CaptainHabibi/Skripsie_Automated_Aquaponic_Control_Platform/ESP32_Pinout.png

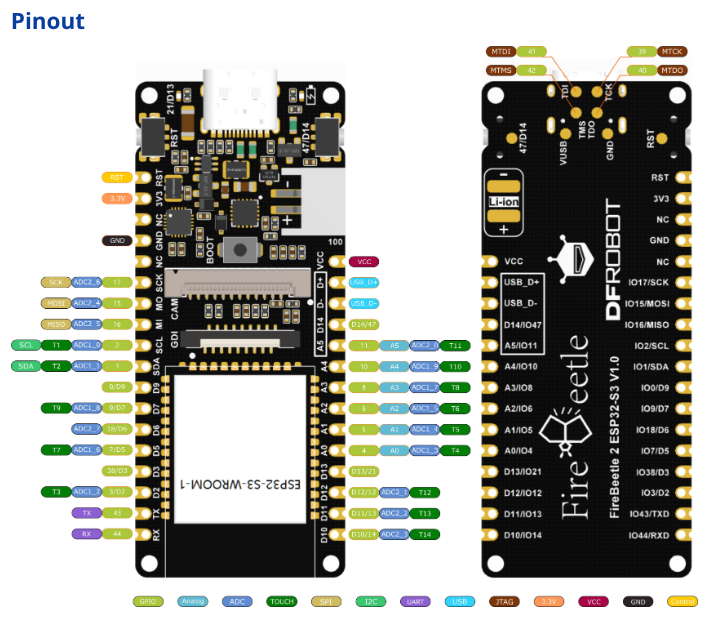
ESP32_Pinout.png
