CaptainHabibi/Skripsie_Automated_Aquaponic_Control_Platform/Screenshot From 2026-08-03 09-43-30.png

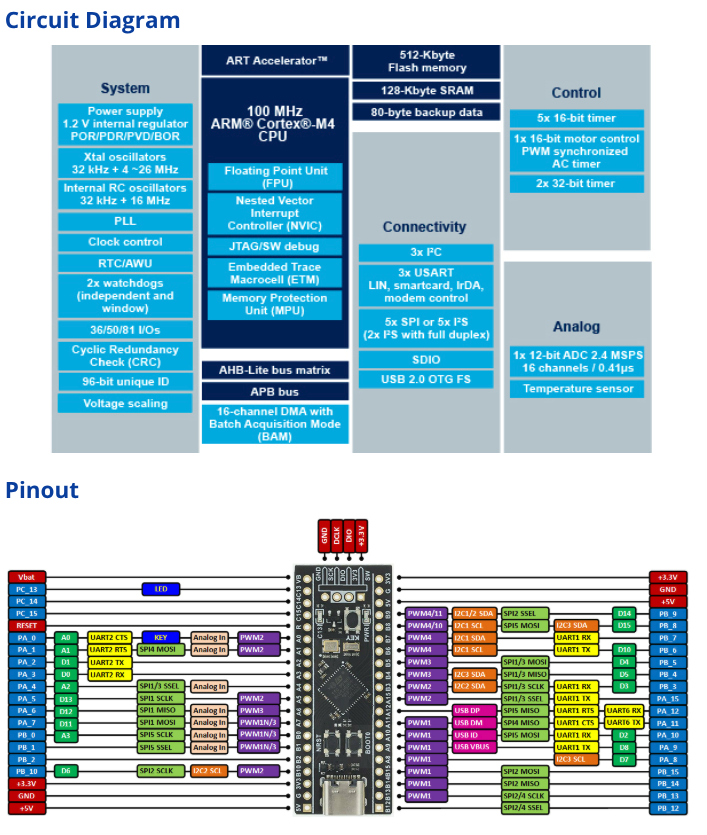
Screenshot From 2026-08-03 09-43-30.png
