CaptainHabibi/Skripsie_Automated_Aquaponic_Control_Platform/Actual_STM.png

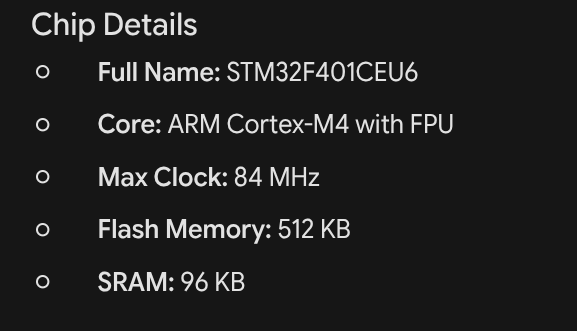
Actual_STM.png
