CaptainHabibi/Skripsie_Automated_Aquaponic_Control_Platform/Esp32_Board.png

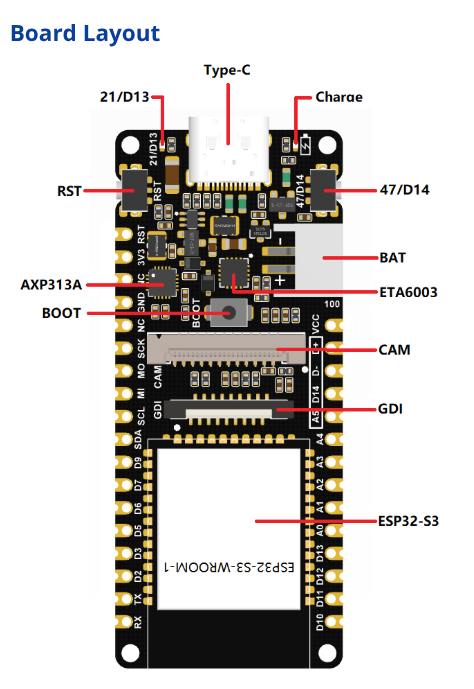
Esp32_Board.png
