CaptainHabibi/Skripsie_Automated_Aquaponic_Control_Platform/ESP32_QuickSpec.png

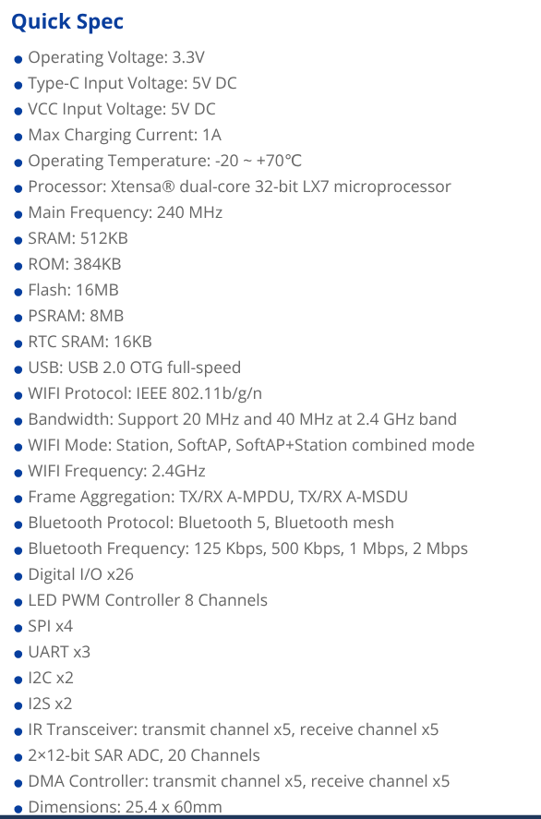
ESP32_QuickSpec.png
