CaptainHabibi/Skripsie_Automated_Aquaponic_Control_Platform/LoRaPinOut_SX1278_LoRa.png

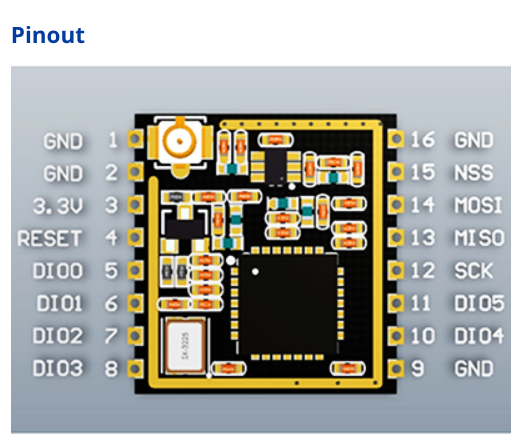
LoRaPinOut_SX1278_LoRa.png
