CaptainHabibi/Skripsie_Automated_Aquaponic_Control_Platform/Servo_Specs.png

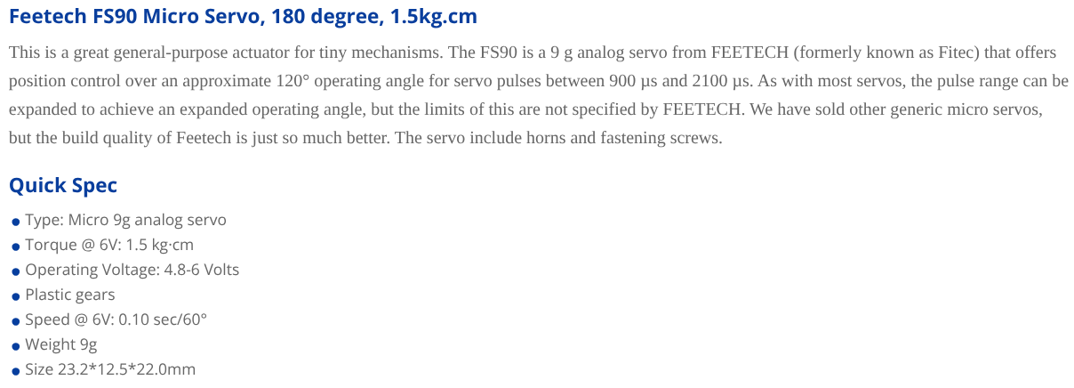
Servo_Specs.png
