CaptainHabibi/Skripsie_Automated_Aquaponic_Control_Platform/SubmersiblePump.png

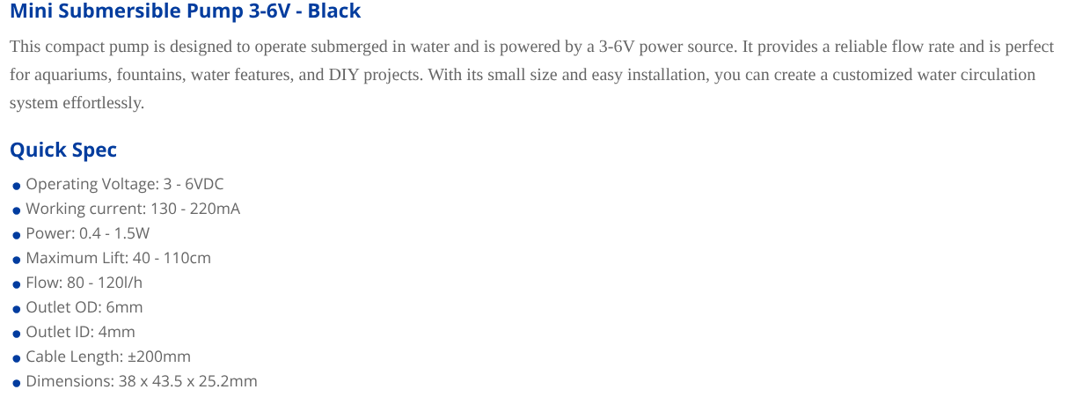
SubmersiblePump.png
