CaptainHabibi/Skripsie_Automated_Aquaponic_Control_Platform/Turbidity.png

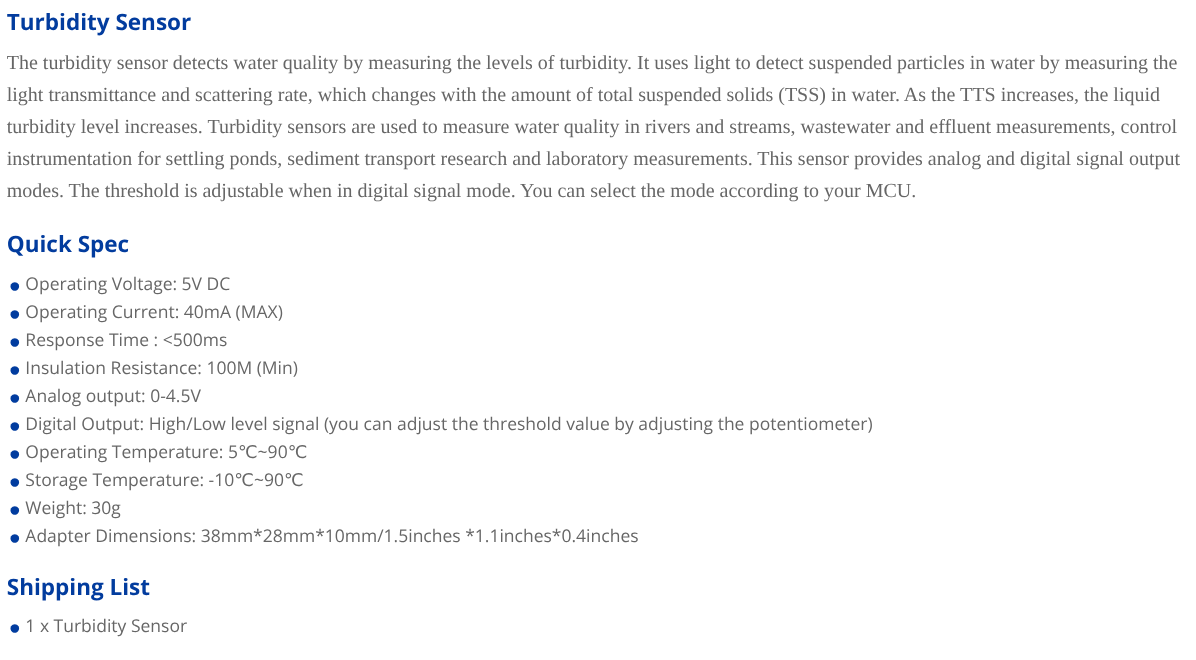
Turbidity.png
