CaptainHabibi/Skripsie_Automated_Aquaponic_Control_Platform/Hardware/Skripsie-PaddleWheel.stl

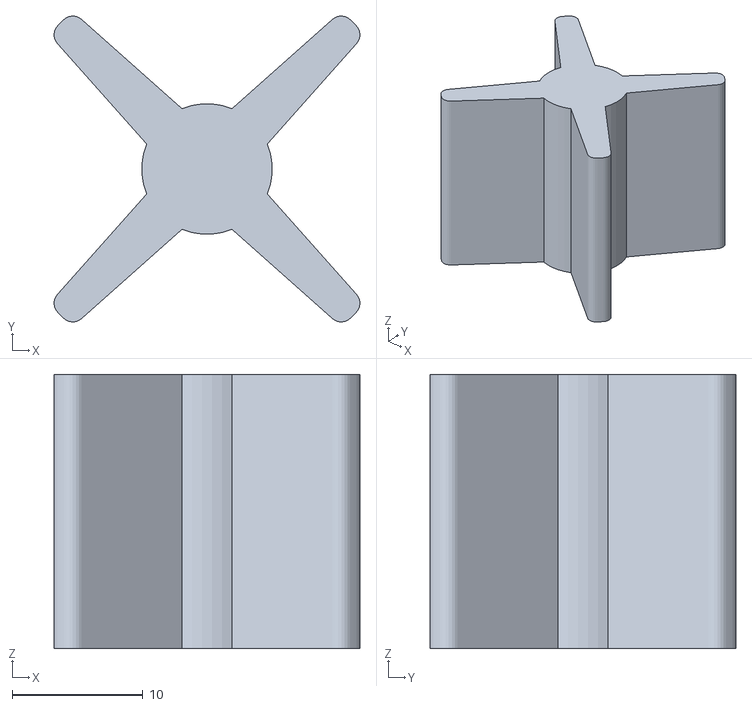
[picture p10: CAD file, 2026-10-30]
Hardware/Skripsie-PaddleWheel.stl
23.4 x 23.4 x 21.0
