CaptainHabibi/Skripsie_Automated_Aquaponic_Control_Platform/Hardware/Skripsie-BackCover.stl

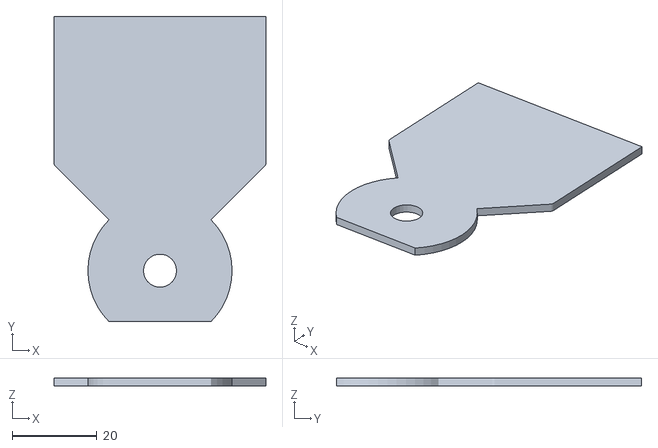
[picture p11: CAD file, 2026-10-30]
Hardware/Skripsie-BackCover.stl
50.0 x 72.0 x 2.00
