CaptainHabibi/Skripsie_Automated_Aquaponic_Control_Platform/Hardware/Receiver_Lid.stl

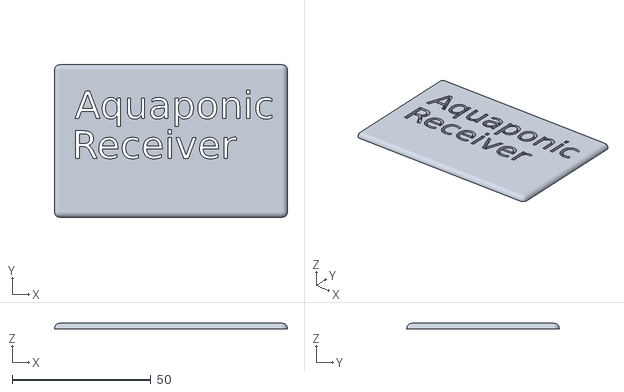
[picture p12: CAD file, 2026-10-30]
Hardware/Receiver_Lid.stl
84.0 x 55.0 x 2.00
