CaptainHabibi/Skripsie_Automated_Aquaponic_Control_Platform/Hardware/UltrasonicMount.stl

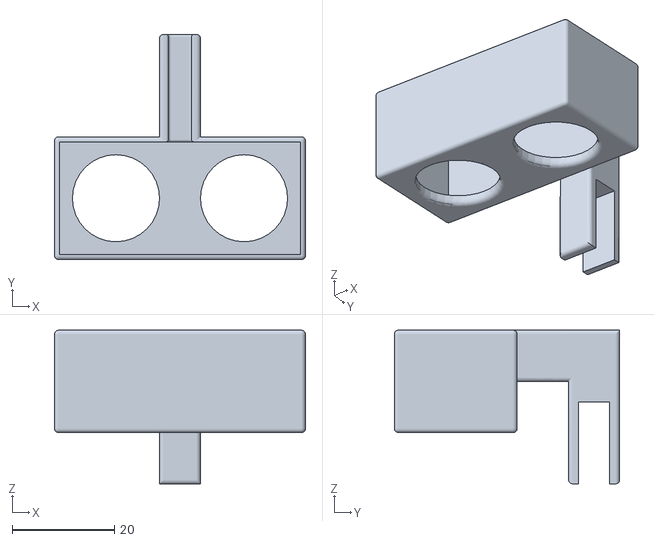
[picture p13: CAD file, 2026-10-30]
Hardware/UltrasonicMount.stl
49.0 x 44.0 x 30.0
