CaptainHabibi/Skripsie_Automated_Aquaponic_Control_Platform/Hardware/Receiver_Box.stl

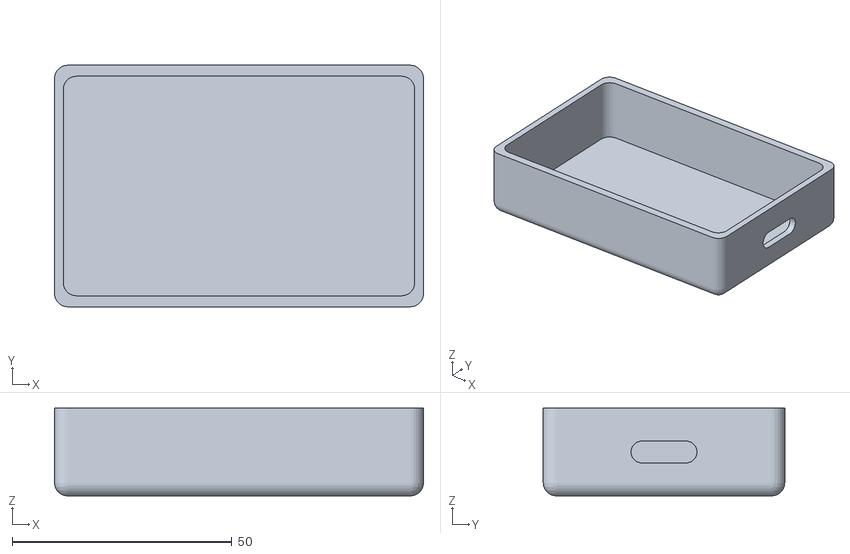
[picture p14: CAD file, 2026-10-30]
Hardware/Receiver_Box.stl
84.0 x 55.0 x 20.0
