CaptainHabibi/Skripsie_Automated_Aquaponic_Control_Platform/Hardware/Skripsie-Housing.stl

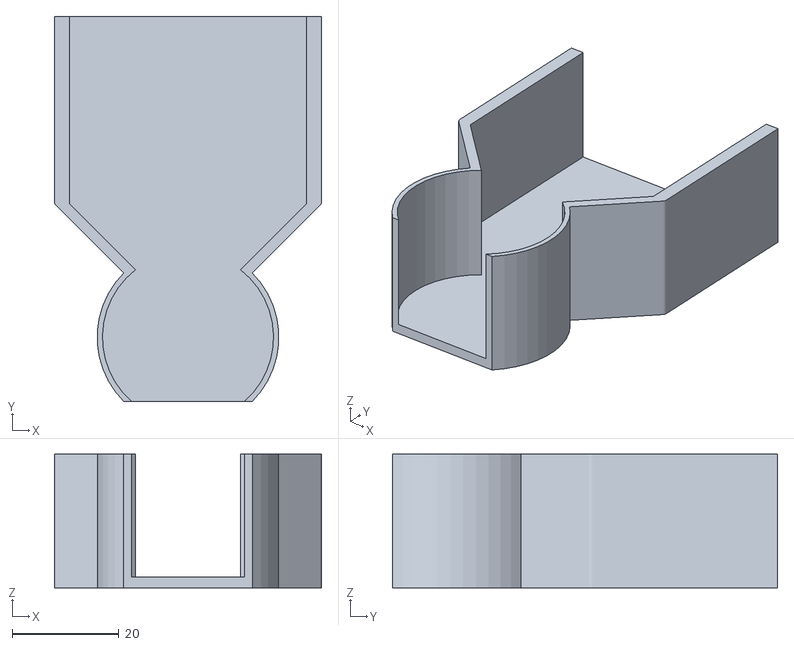
[picture p15: CAD file, 2026-10-30]
Hardware/Skripsie-Housing.stl
50.0 x 72.0 x 25.0
