CaptainHabibi/Skripsie_Automated_Aquaponic_Control_Platform/Hardware/ServoMount.stl

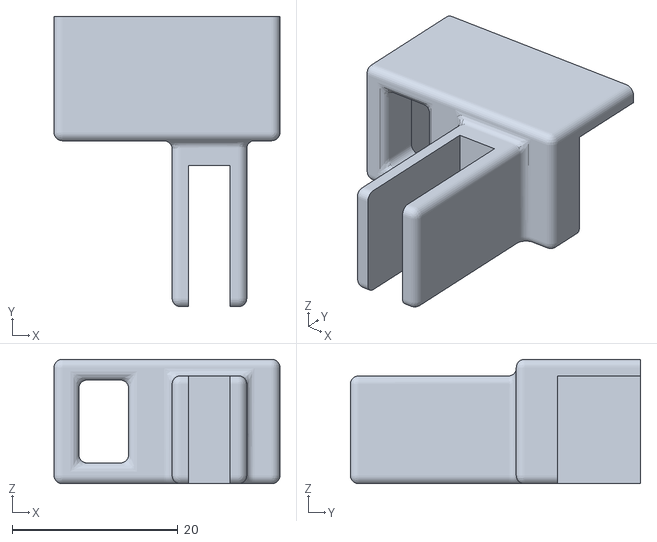
[picture p16: CAD file, 2026-10-30]
Hardware/ServoMount.stl
27.2 x 35.0 x 15.0
