CaptainHabibi/Skripsie_Automated_Aquaponic_Control_Platform/Hardware/Skripsie.pdf

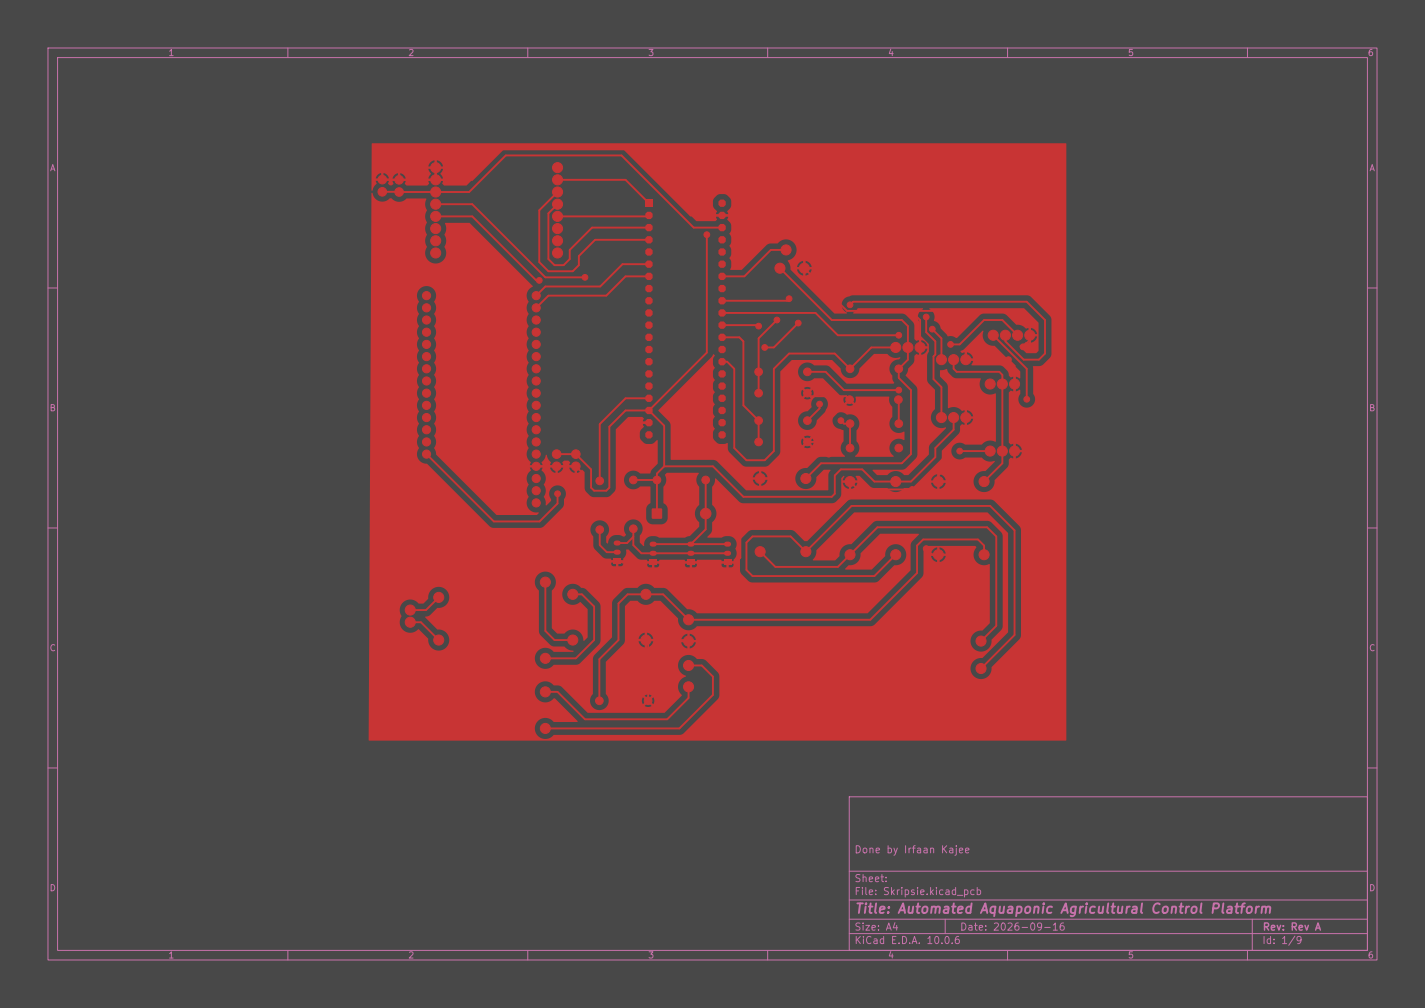
[picture p17: page 1]

Done by Irfaan Kajee

Sheet:
File: Skripsie.kicad_pcb
Title: Automated Aquaponic Agricultural Control Platform

Size: A4 | Rev: Rev A
KiCad E.D.A. 10.0.6 | Id: 1/9

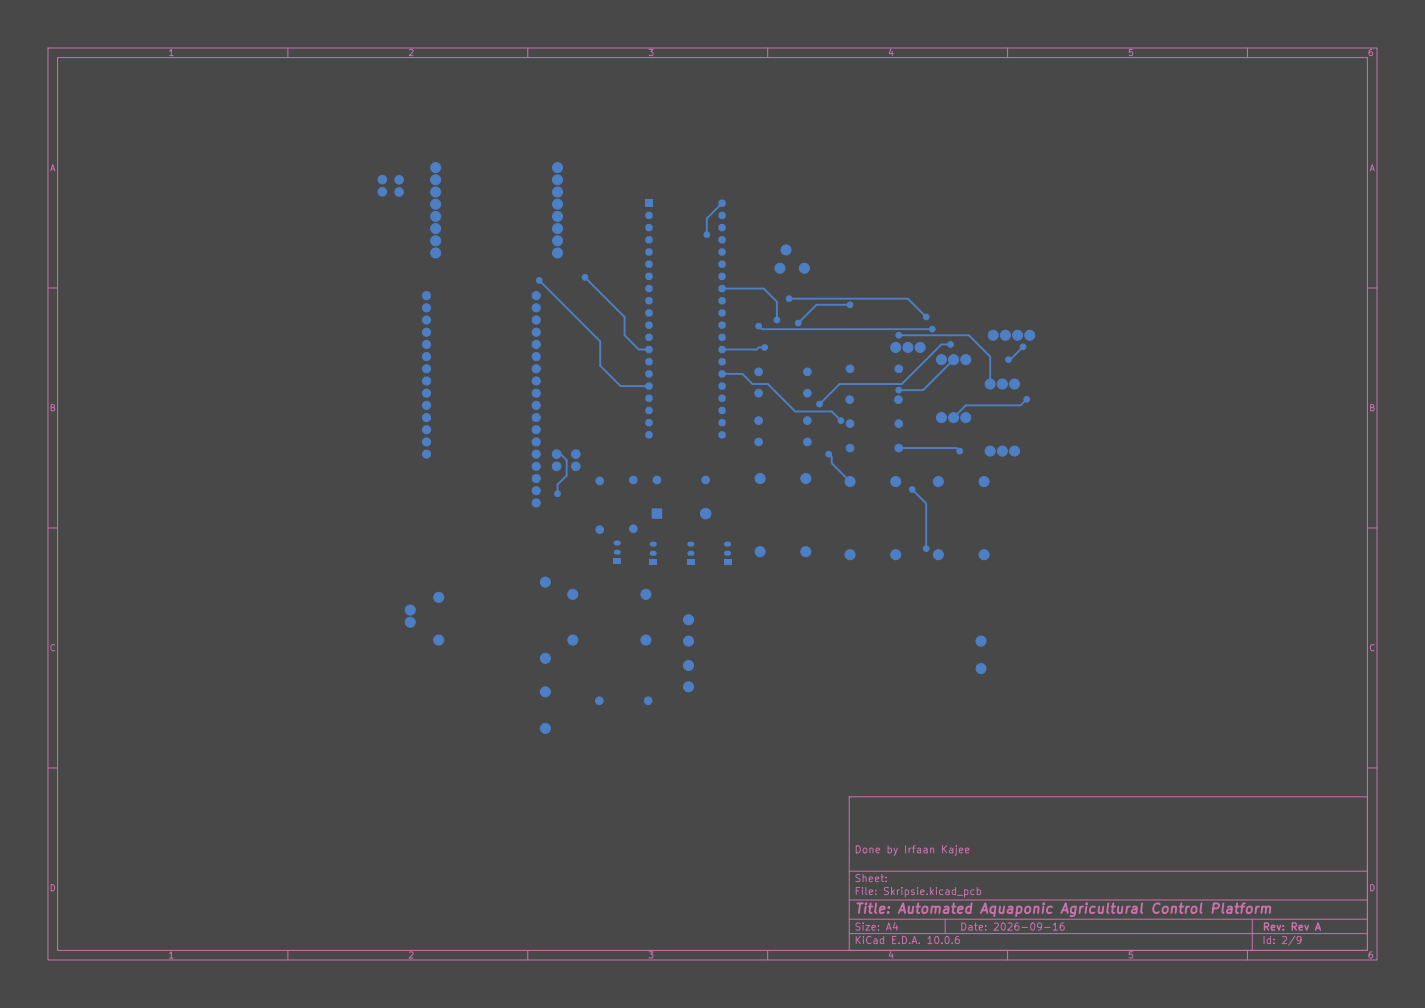
[picture p18: page 2]

Done by Irfaan Kajee

Sheet:
File: Skripsie.kicad_pcb
Title: Automated Aquaponic Agricultural Control Platform

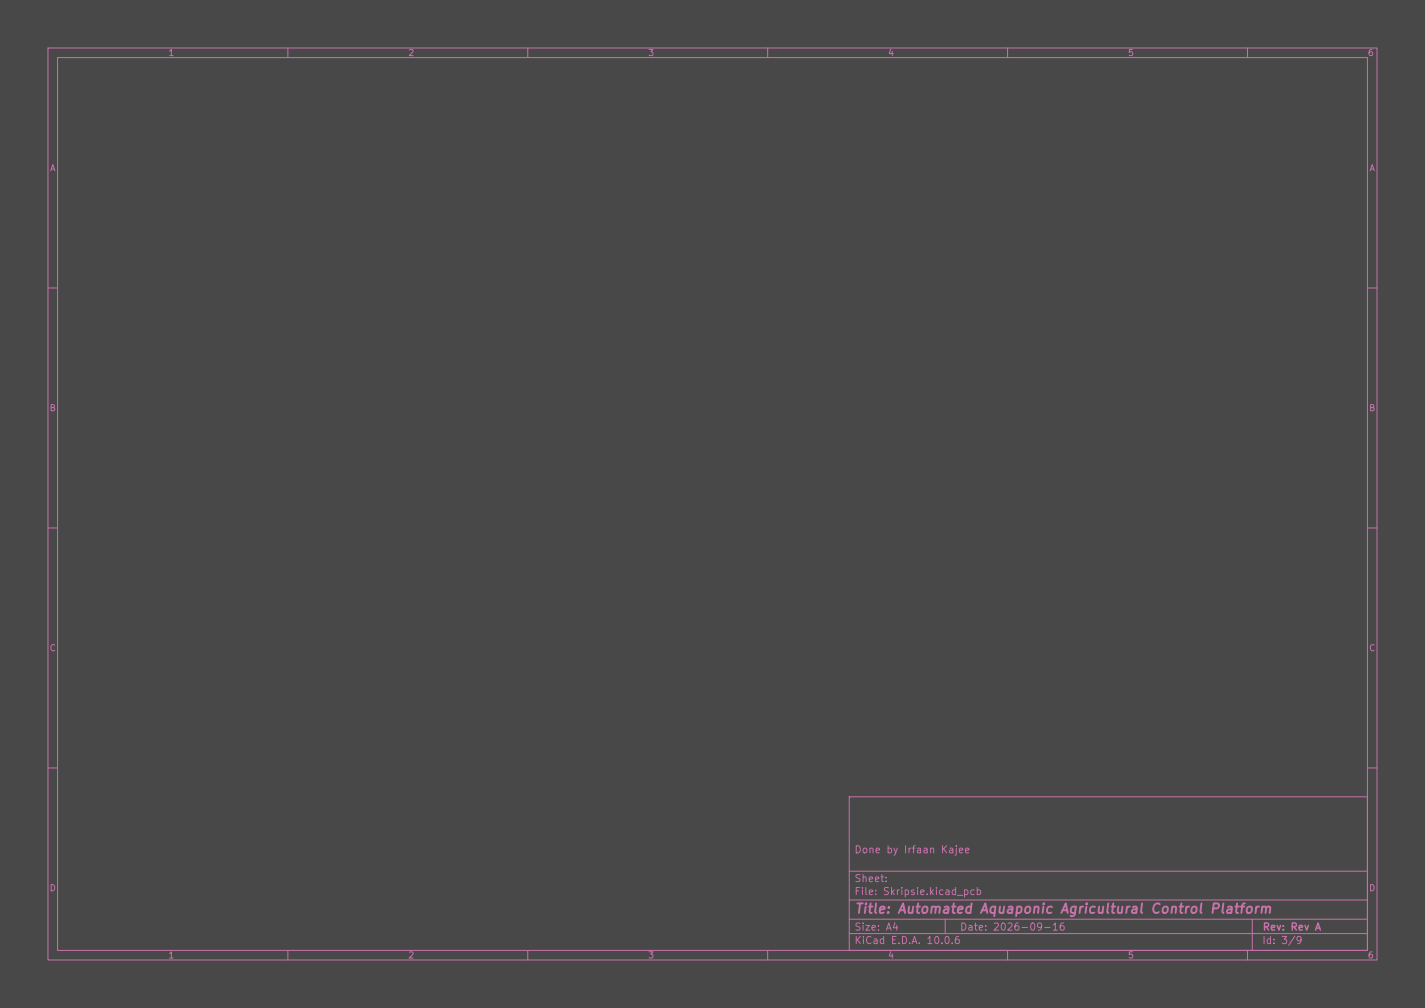
[picture p19: page 3]

Done by Irfaan Kajee

Sheet:
File: Skripsie.kicad_pcb
Title: Automated Aquaponic Agricultural Control Platform

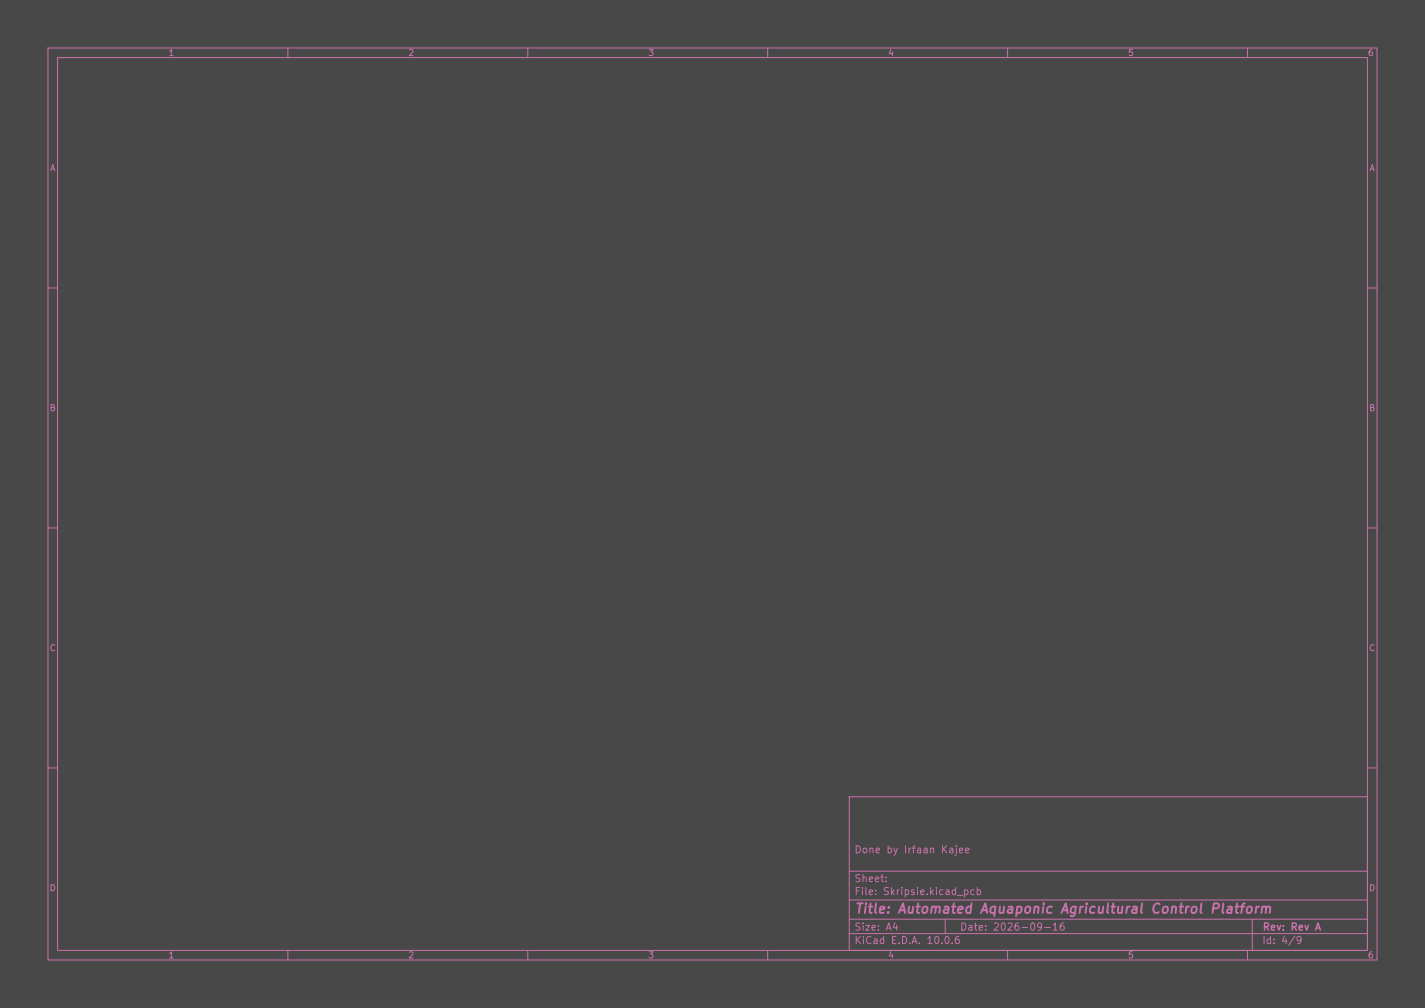
[picture p20: page 4]

Done by Irfaan Kajee

Sheet:
File: Skripsie.kicad_pcb
Title: Automated Aquaponic Agricultural Control Platform

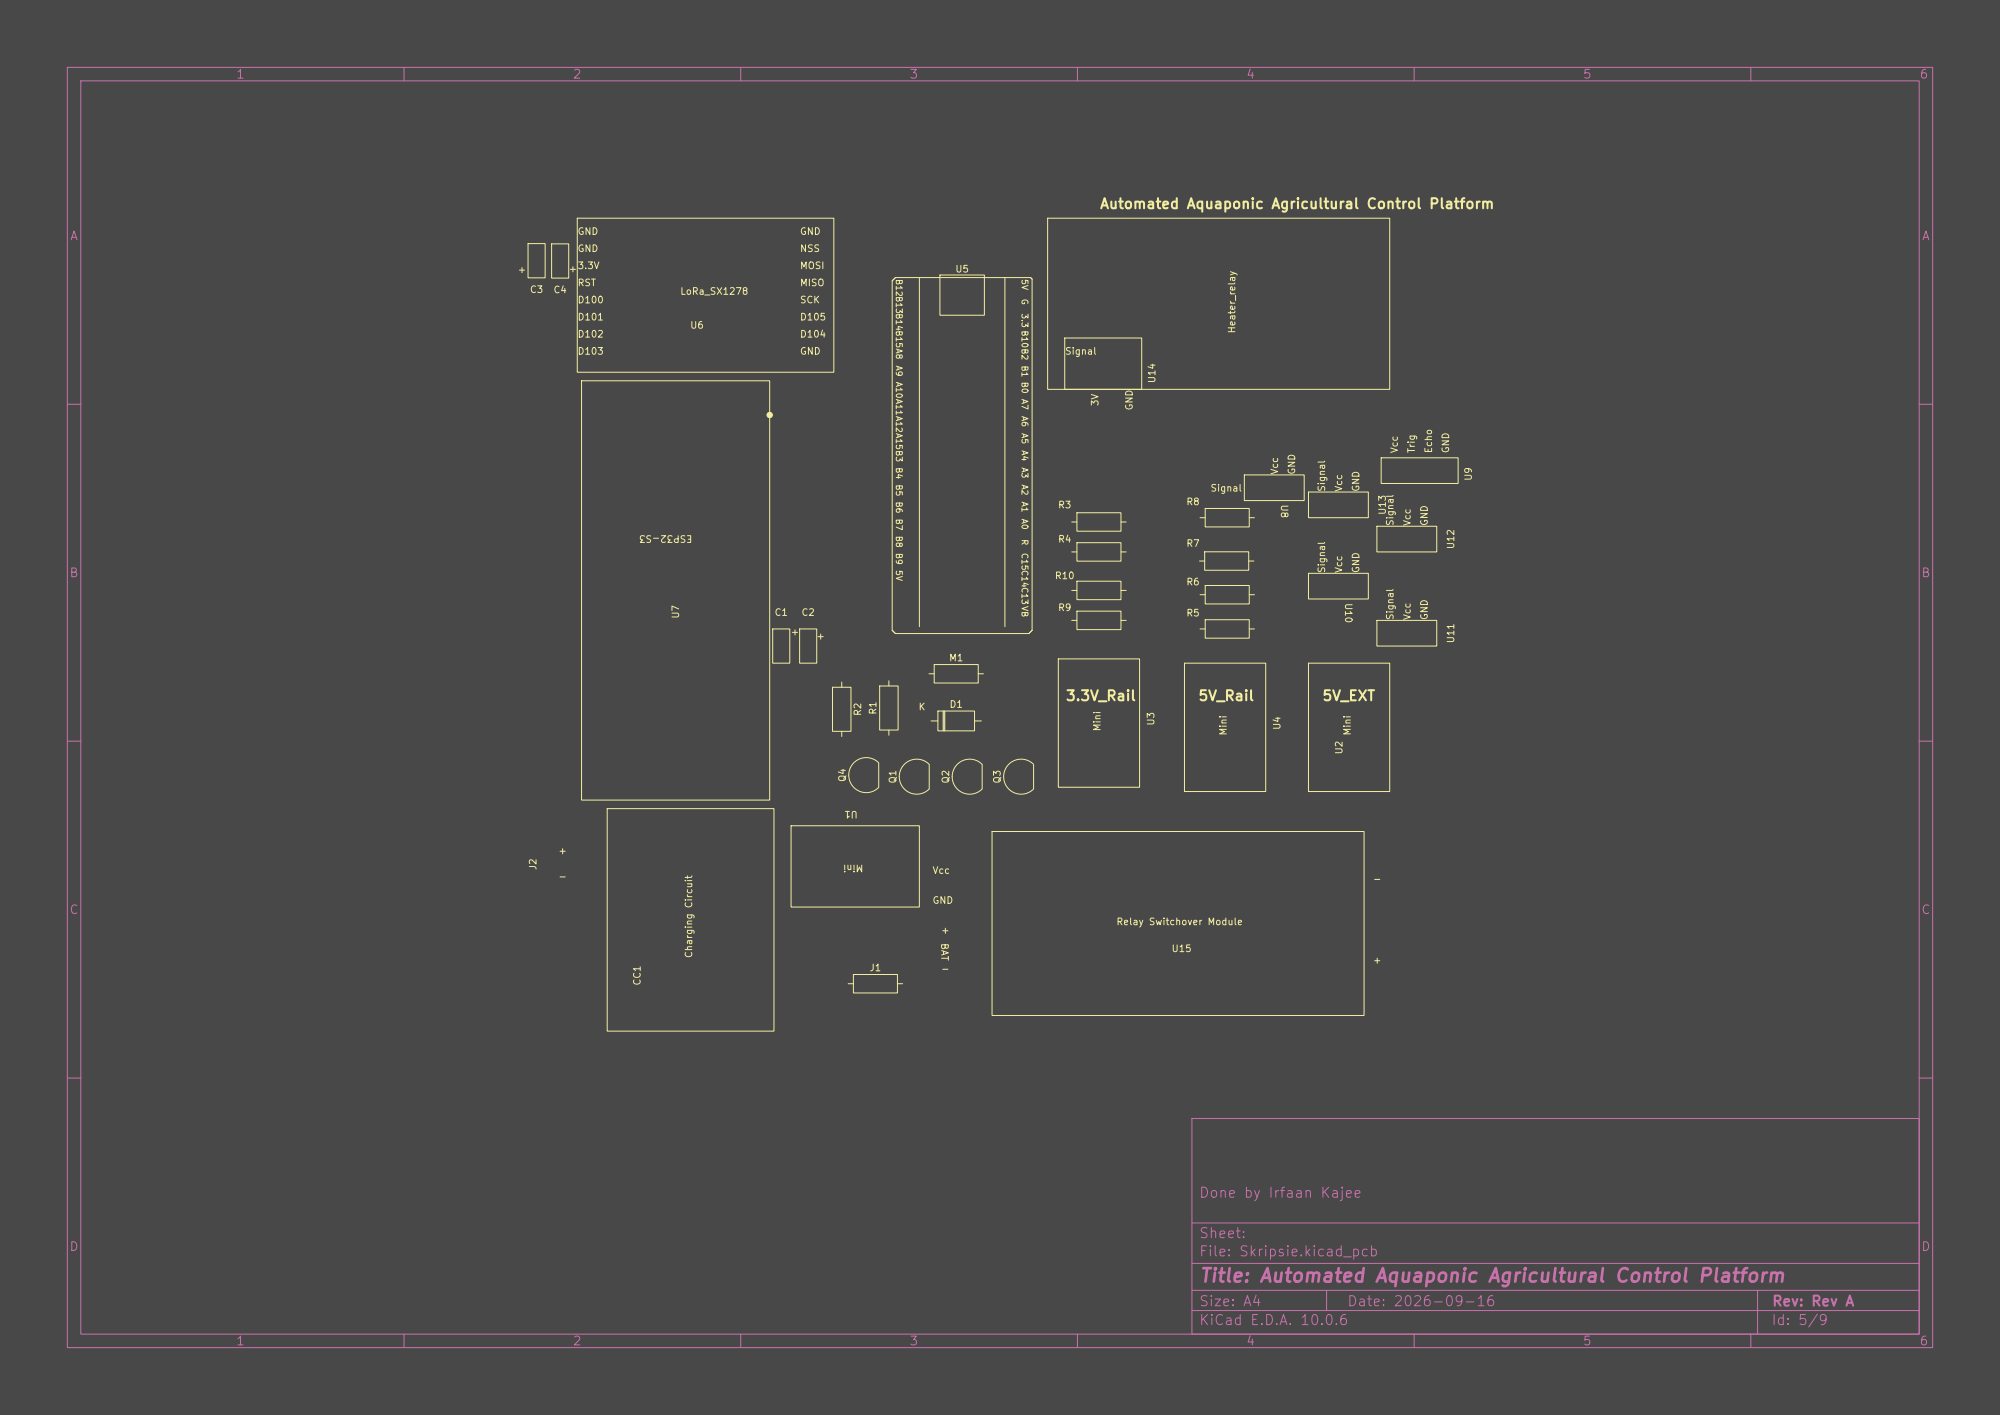
[picture p21: page 5]

Automated Aquaponic Agricultural Control Platform

Done by Irfaan Kajee

Sheet:
File: Skripsie.kicad_pcb
Title: Automated Aquaponic Agricultural Control Platform

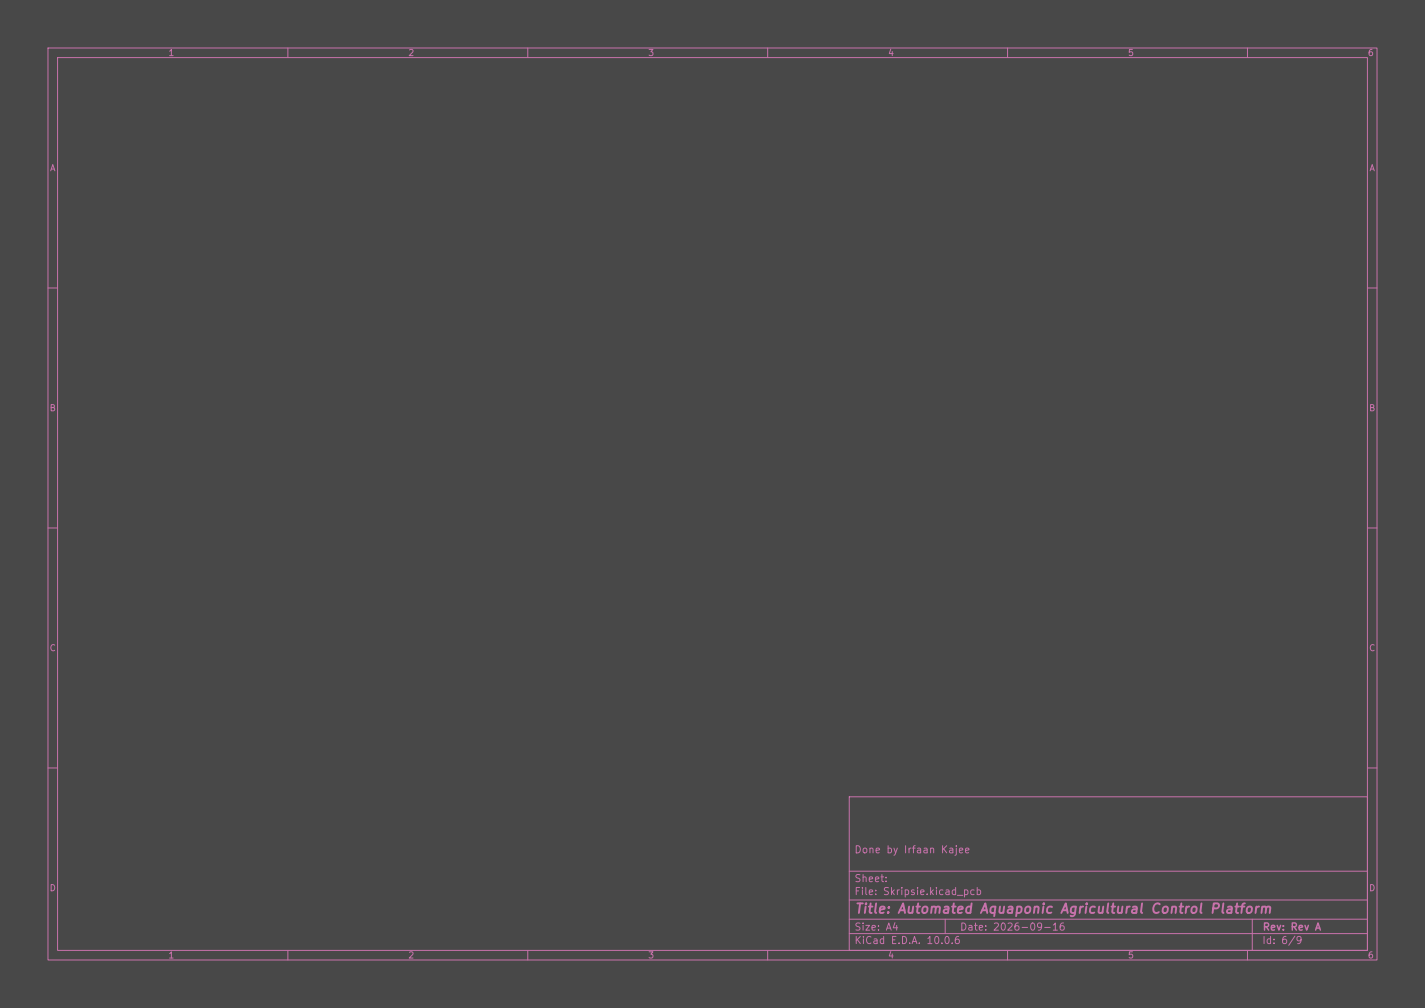
[picture p22: page 6]

Done by Irfaan Kajee

Sheet:
File: Skripsie.kicad_pcb
Title: Automated Aquaponic Agricultural Control Platform

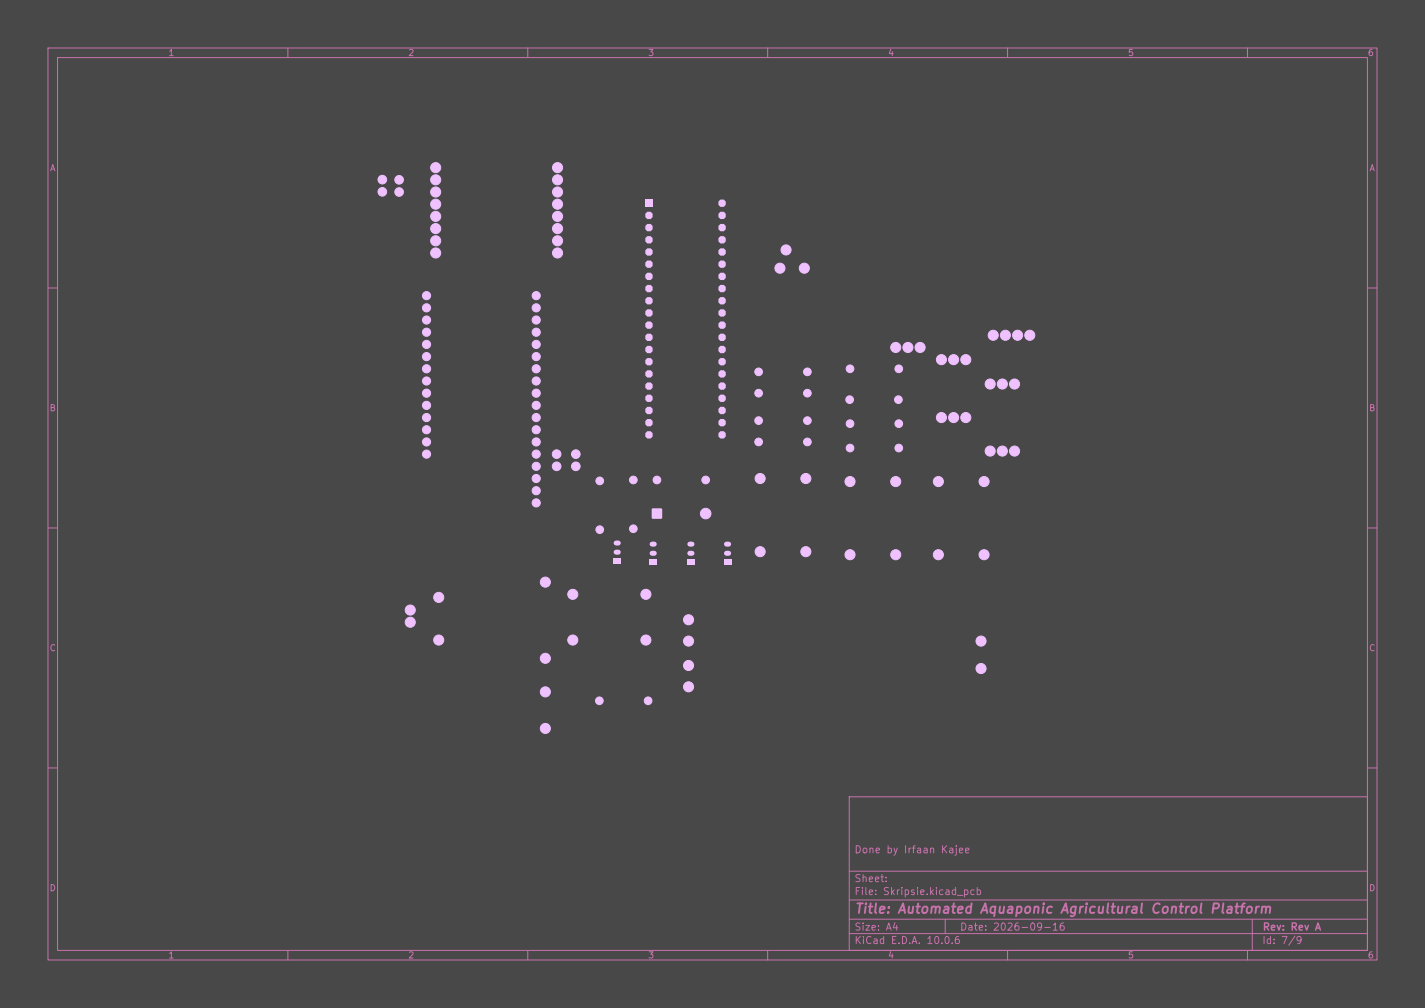
[picture p23: page 7]

Done by Irfaan Kajee

Sheet:
File: Skripsie.kicad_pcb
Title: Automated Aquaponic Agricultural Control Platform

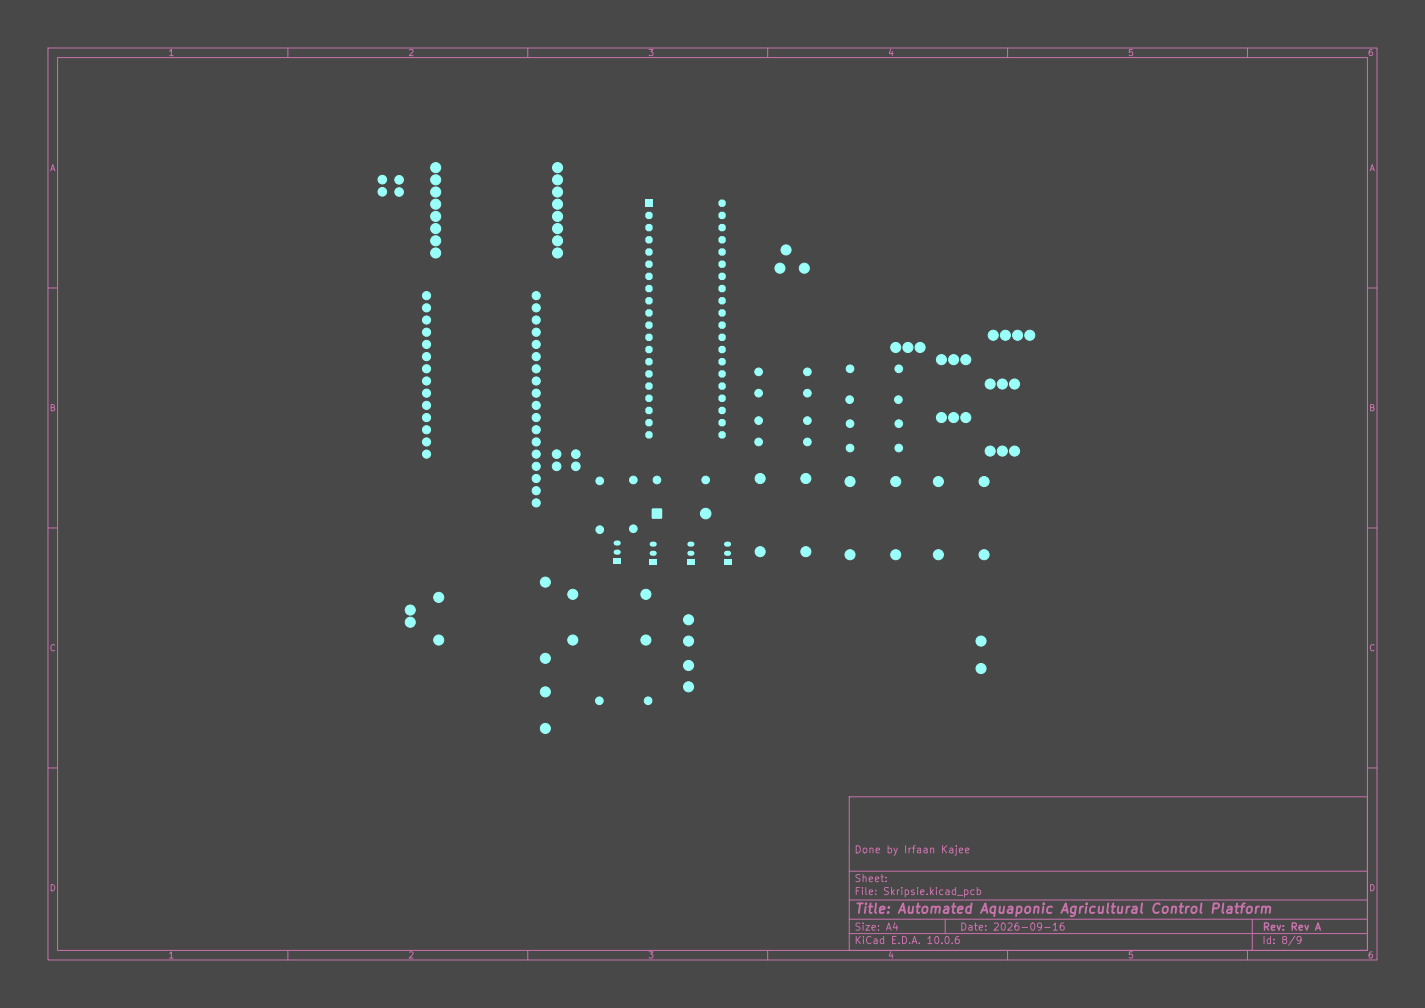
[picture p24: page 8]

Done by Irfaan Kajee

Sheet:
File: Skripsie.kicad_pcb
Title: Automated Aquaponic Agricultural Control Platform

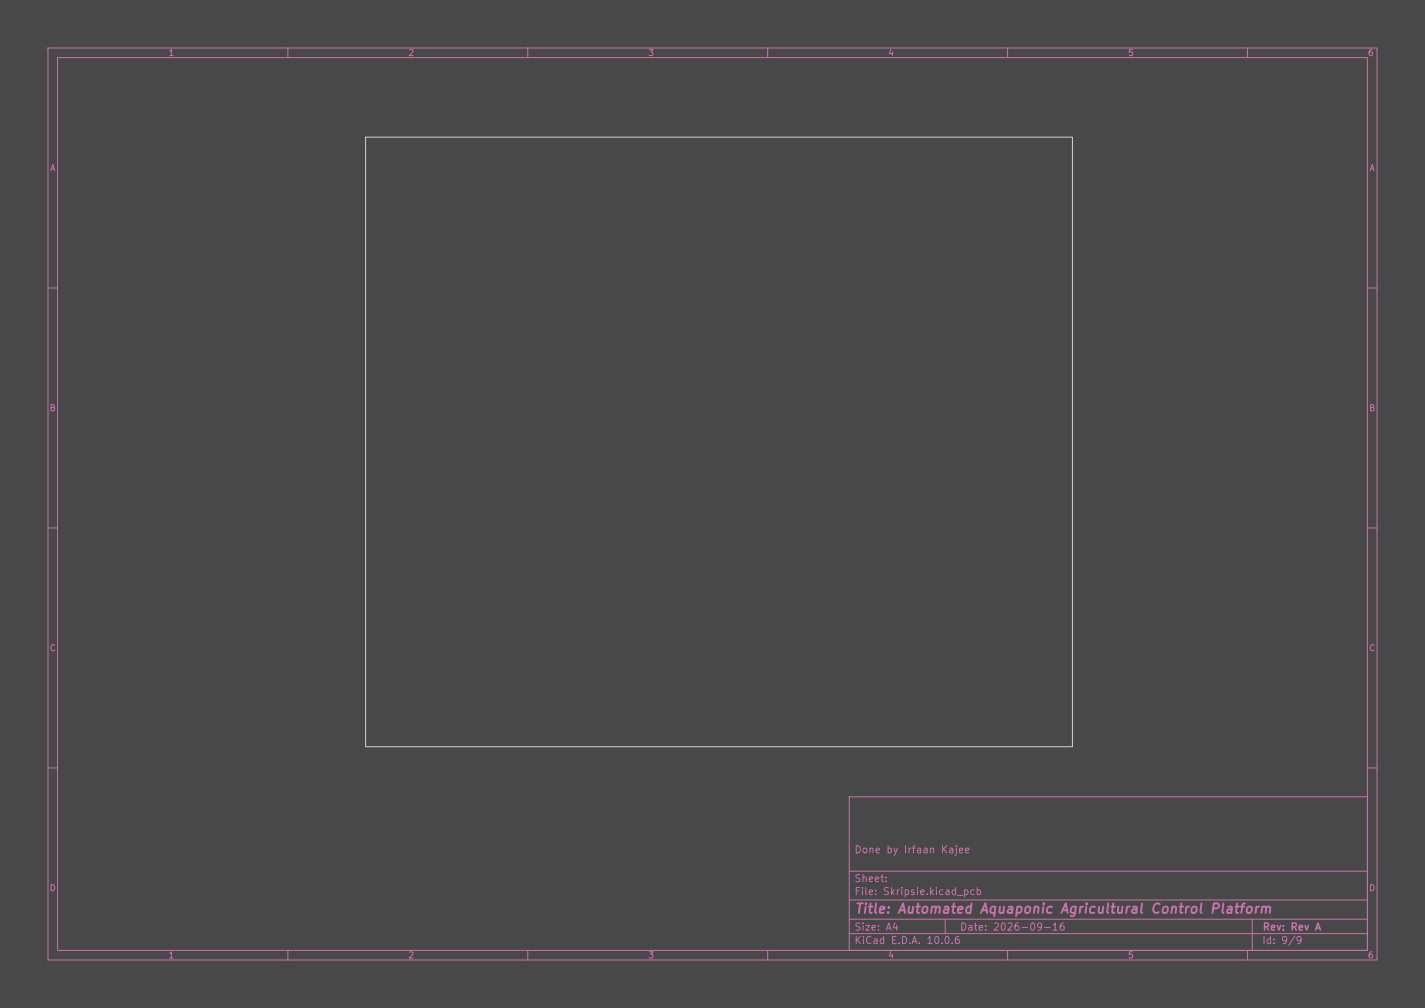
[picture p25: page 9]

Done by Irfaan Kajee

Sheet:
File: Skripsie.kicad_pcb
Title: Automated Aquaponic Agricultural Control Platform
