CaptainHabibi/Skripsie_Automated_Aquaponic_Control_Platform/Hardware/PCB_BlackWhite.pdf

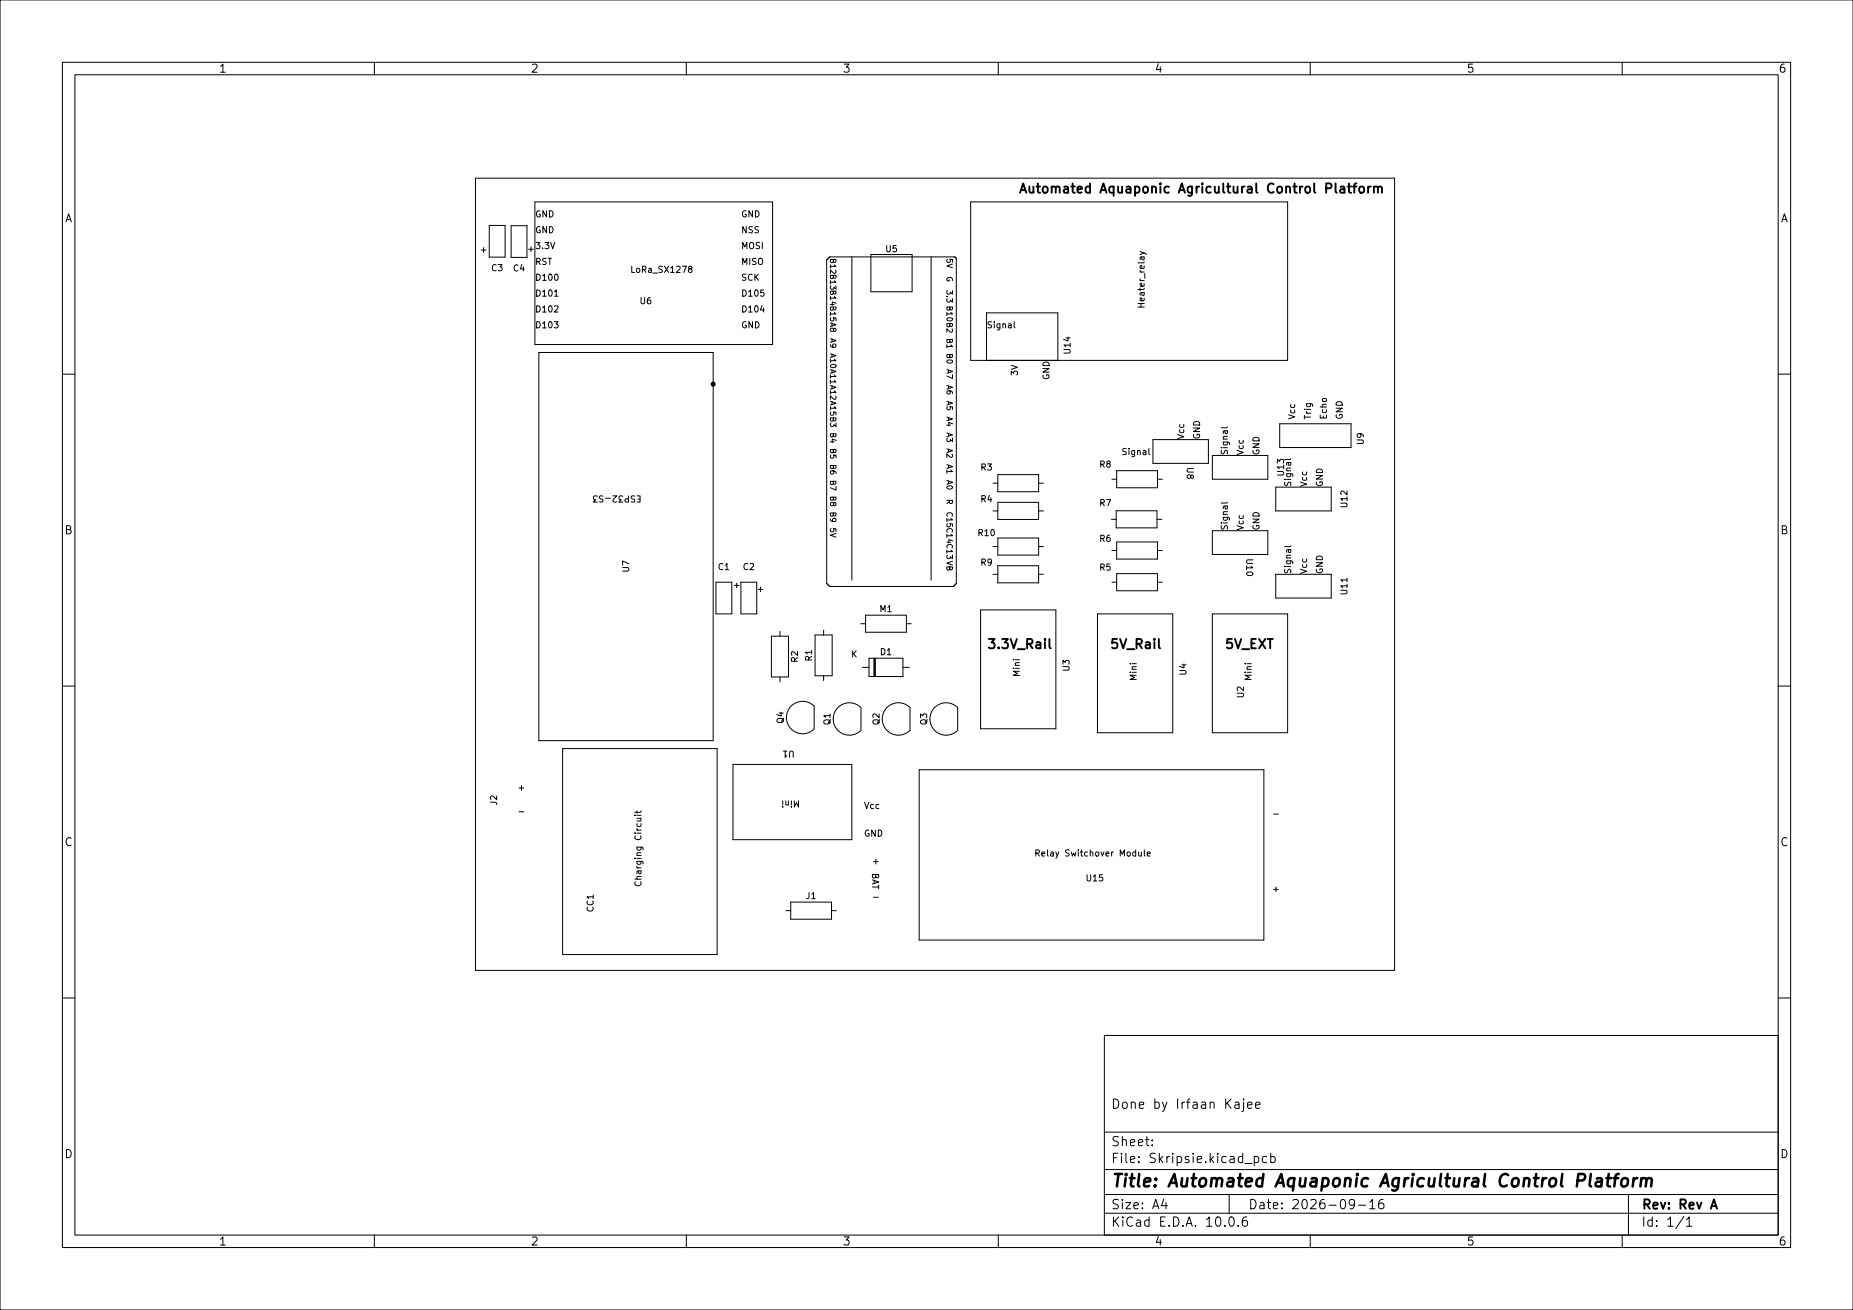
[picture p26: page 1]
