CaptainHabibi/Skripsie_Automated_Aquaponic_Control_Platform/Hardware/Skripsie.kicad_pcb

## KiCad design Hardware/Skripsie.kicad_pcb (2026-10-30)

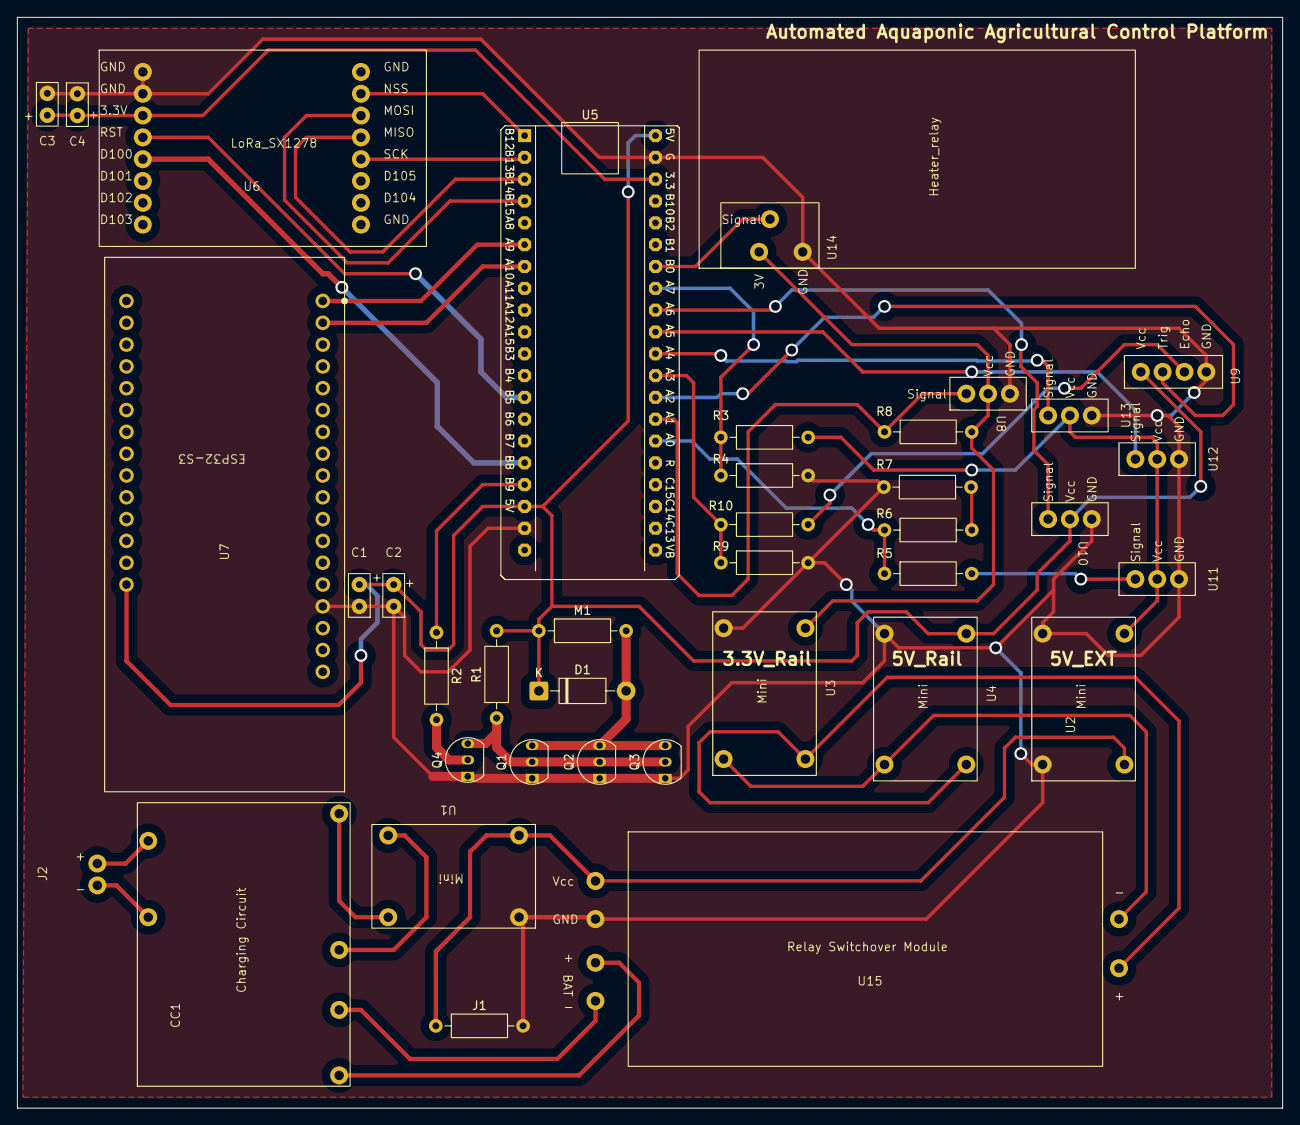
[picture p27: board Skripsie.kicad_pcb from above]

Board: 2 copper layers, 147.3 x 127.0 mm, 38 parts (0 on the bottom side), 38 nets.

Parts:
C1, C3: 100n; Capacitor_Lab
C2, C4: 100u; Capacitor_Lab
CC1: Charging_Circuit
D1: 1N4007; D_DO-41_SOD81_P10.16mm_Horizontal
J1: Barrel_Jack; R_Axial_DIN0207_L6.3mm_D2.5mm_P10.16mm_Horizontal
J2: Battery Connector Pins; BattConnector
M1: Motor_DC; R_Axial_DIN0207_L6.3mm_D2.5mm_P10.16mm_Horizontal
Q1, Q2, Q3: 2N7000; TO-92_Inline
Q4: 2N3904; TO-92_Inline
R1: 680; R_Axial_DIN0207_L6.3mm_D2.5mm_P10.16mm_Horizontal
R2, R10: 1k; R_Axial_DIN0207_L6.3mm_D2.5mm_P10.16mm_Horizontal
R3, R5: 12k; R_Axial_DIN0207_L6.3mm_D2.5mm_P10.16mm_Horizontal
R4: 22k; R_Axial_DIN0207_L6.3mm_D2.5mm_P10.16mm_Horizontal
R6: 30k; R_Axial_DIN0207_L6.3mm_D2.5mm_P10.16mm_Horizontal
R7: 3.3k; R_Axial_DIN0207_L6.3mm_D2.5mm_P10.16mm_Horizontal
R8: 4.7k; R_Axial_DIN0207_L6.3mm_D2.5mm_P10.16mm_Horizontal
R9: 2k; R_Axial_DIN0207_L6.3mm_D2.5mm_P10.16mm_Horizontal
U1, U2, U3, U4: VoltageRegulator_ZX_Mini_360
U5: STM32F411 BlackPill; STM32F411_Black_Pill
U6: LoRa_SX1278
U7: FireBeetle2_ESP32S3
U8, U10, U11, U12, U13: Sensor_Interface_3Pin
U9: UltraSonic_HCSR04
U14: Heater_Relay_Footprint
U15: Switchover_Relay

Connections:
3.3V_Rail: R8.2, U3.4 (OUT+), U8.2 (VDD), U14.1 (3V)
5V_EXT: R3.1, U2.4 (OUT+), U11.2 (Vcc), U12.2 (Vcc), U13.2 (Vcc)
5V_Rail: C1.1, C2.1, D1.1 (K), M1.1 (+), R1.2, U4.4 (OUT+), U5.18 (5V), U5.40 (5V), U7.19 (VCC), U9.4 (Vcc), U10.2 (Vcc)
+12V: J1.1, U1.2 (IN+), U2.2 (IN+), U15.1 (Vcc)
/3.3V_STM: C3.1, C4.1, U5.38 (3.3V), U6.3 (3.3V)
/ECSensor: U5.31 (A5), U12.3 (Signal)
/Echo: R9.1, R10.2, U5.29 (A3)
/HeaterRelay: U5.34 (B0), U14.2 (Signal)
/LoRa_CS: U5.1 (B12), U6.10 (NSS)
/LoRa_D100: U5.16 (B8), U6.5 (D100)
/LoRa_Rst: U5.13 (B5), U6.4 (RST)
/PHSensor: U5.30 (A4), U13.3 (Signal)
/PowerCheck: R3.2, R4.1, U5.33 (A7)
/Pump_PWM: R2.1, U5.17 (B9)
/SPI2_MISO: U5.3 (B14), U6.12 (MISO)
/SPI2_MOSI: U5.4 (B15), U6.11 (MOSI)
/SPI2_SCK: U5.2 (B13), U6.13 (SCK)
/Servo_PWM: U5.32 (A6), U10.3 (Signal)
/TempSensorPin: R8.1, U5.27 (A1), U8.3 (Signal)
/Trig: U5.28 (A2), U9.3 (Trig)
/Turbidity: R5.1, R6.2, U5.26 (A0)
/USART1_RX: U5.7 (A10), U7.2 (TX)
/USART1_TX: U5.6 (A9), U7.1 (RX)
GND: C1.2, C2.2, C3.2, C4.2, J1.2, Q1.1 (S), Q2.1 (S), Q3.1 (S), Q4.1 (E), R4.2, R7.2, R9.2, U1.1 (IN-), U2.1 (IN-), U2.3 (OUT-), U3.3 (OUT-), U4.3 (OUT-), U5.19 (G), U5.39 (G), U6.1 (GND), U6.2 (GND), U7.15 (GND), U8.1 (GND), U9.1 (GND), U10.1 (GND), U11.1 (GND), U12.1 (GND), U13.1 (GND), U14.3 (GND), U15.2 (GND)
unnamed: CC1.3 (BAT+), J2.2
unnamed: CC1.4 (BAT-), J2.1
unnamed: CC1.5 (IN+), U1.4 (OUT+)
unnamed: CC1.6 (IN-), U1.3 (OUT-)
unnamed: CC1.1 (Vout+), U15.3 (BAT+)
unnamed: CC1.2 (Vout-), U15.4 (BAT-)
unnamed: D1.2 (A), M1.2 (-), Q1.3 (D), Q2.3 (D), Q3.3 (D)
unnamed: Q1.2 (G), Q2.2 (G), Q3.2 (G), Q4.3 (C), R1.1
unnamed: Q4.2 (B), R2.2
unnamed: R6.1, R7.1
unnamed: R10.1, U9.2 (Echo)
unnamed: R5.2, U11.3 (Signal)
unnamed: U3.2 (IN+), U4.2 (IN+), U15.5 (OUT+)
unnamed: U3.1 (IN-), U4.1 (IN-), U15.6 (OUT-)
