CaptainHabibi/Skripsie_Automated_Aquaponic_Control_Platform/STM32Core/main.h

#define ledPin_Pin GPIO_PIN_13
#define ledPin_GPIO_Port GPIOC
#define Turbidity_Pin GPIO_PIN_0
#define Turbidity_GPIO_Port GPIOA
#define TempSensorPin_Pin GPIO_PIN_1
#define TempSensorPin_GPIO_Port GPIOA
#define Trig_Pin GPIO_PIN_2
#define Trig_GPIO_Port GPIOA
#define Echo_Pin GPIO_PIN_3
#define Echo_GPIO_Port GPIOA
#define PHSensor_Pin GPIO_PIN_4
#define PHSensor_GPIO_Port GPIOA
#define ECSensor_Pin GPIO_PIN_5
#define ECSensor_GPIO_Port GPIOA
#define Servo_PWM_Pin GPIO_PIN_6
#define Servo_PWM_GPIO_Port GPIOA
#define PowerCheck_Pin GPIO_PIN_7
#define PowerCheck_GPIO_Port GPIOA
#define HeaterRelay_Pin GPIO_PIN_0
#define HeaterRelay_GPIO_Port GPIOB
#define LoRa_CS_Pin GPIO_PIN_12
#define LoRa_CS_GPIO_Port GPIOB
#define LoRa_Rst_Pin GPIO_PIN_5
#define LoRa_Rst_GPIO_Port GPIOB
#define LoRa_D100_Pin GPIO_PIN_8
#define LoRa_D100_GPIO_Port GPIOB
