CaptainHabibi/Skripsie_Automated_Aquaponic_Control_Platform/STM32Core/LoRa.h

#ifndef LORA_H
#define LORA_H

#include "main.h"
#include <stdint.h>
#include <string.h>

/* SX1278 registers */
#define REG_FIFO                 0x00
#define REG_OP_MODE              0x01
#define REG_FRF_MSB              0x06
#define REG_FRF_MID              0x07
#define REG_FRF_LSB              0x08
#define REG_PA_CONFIG            0x09
#define REG_FIFO_ADDR_PTR        0x0D
#define REG_FIFO_TX_BASE_ADDR    0x0E
#define REG_FIFO_RX_BASE_ADDR    0x0F
#define REG_FIFO_RX_CURRENT_ADDR 0x10
#define REG_IRQ_FLAGS            0x12
#define REG_RX_NB_BYTES          0x13
#define REG_MODEM_CONFIG_1       0x1D
#define REG_MODEM_CONFIG_2       0x1E
#define REG_PAYLOAD_LENGTH       0x22
#define REG_MODEM_CONFIG_3       0x26
#define REG_DIO_MAPPING_1        0x40
#define REG_VERSION              0x42

/* Op modes */
#define MODE_LONG_RANGE_MODE     0x80
#define MODE_SLEEP               0x00
#define MODE_STDBY               0x01
#define MODE_TX                  0x03
#define MODE_RXCONTINUOUS        0x05

/* IRQ masks */
#define IRQ_TX_DONE_MASK            0x08
#define IRQ_PAYLOAD_CRC_ERROR_MASK  0x20
#define IRQ_RX_DONE_MASK            0x40

/* Prototypes */
uint8_t LoRa_Init(void);
uint8_t LoRa_Transmit(uint8_t *payload, uint8_t length);
uint8_t LoRa_ReadRegister(uint8_t address);
void    LoRa_WriteRegister(uint8_t address, uint8_t value);
void    LoRa_Reset(void);
void    LoRa_Sleep(void);

void    LoRa_StartReceive(void);
uint8_t LoRa_ReceivePacket(uint8_t *buf, uint8_t maxlen);

#endif /* LORA_H */
