CaptainHabibi/Skripsie_Automated_Aquaponic_Control_Platform/(commit log)

2026-08-07 Version 1.0
    Working RTOS with Temperature Sensor working
2026-08-10 Skripsie v1.1
    working temp sensor and water level ultrasonic sensor
2026-08-29 Skripsie v2.0
    Working thermal subcontrol system and working sensor code.
2026-08-29 Skripsie V2.1
    Uploaded latest sensor codes and also lora's humble beginnings
2026-09-10 Skripsie v2.3
    Latest and greatest. all sensors working. LoRa and Cam working too. no ai model yet.
2026-09-21 Skripsie v2.4
    Massive Wins. Updated code for:
    - manual commands via lora
    - live graphs via lora with a webapp
    - working sensors overall.
    - hopefully final version will be done soon with ML feeding model
2026-10-04 Skripsie V2.4.1
    - fixed working manual commands
    - glassmorphism dashboard
    - faster responsiveness on Lora Graphs
    - updated freertos.c and main.c
    -TODO: vision model
    [ESP32_Skripsie_Receiver.ino, common.h, downlink.h, uplink.h]
2026-10-20 Skripsie V3.0
    Great Improvements:
    - Servo angles fixed and timing
    - All sensors calibrated correctly
    - The best thus far!
    [ECSensor.c, PHSensor.c, Pump.c, downlink.h, servoMotor.c, servoMotor.h]
2026-10-30 All Updated Files
    Includes:
    - STM32 Code
    - ESP32Cam Code
    - ESP32 Gateway Code
    - KiCad files
    - 3D Printing STL Files
    - Python Graph Code
    - NGSPICE Netlist for pump driver
    [Receiver_Box.stl, Receiver_Lid.stl, ServoMount.stl, Skripsie-BackCover.stl, Skripsie-Housing.stl, Skripsie-PaddleWheel.stl, Skripsie.kicad_pcb, Skripsie.kicad_sch]
