CaptainHabibi/Skripsie_Automated_Aquaponic_Control_Platform/(notices)

Notices in the files:
STM32Core/main.c:
Copyright (c) 2026 STMicroelectronics.
All rights reserved.
This software is licensed under terms that can be found in the LICENSE file
